TylerK07/HexCalc/images/HexCalc_PCB_Back.png

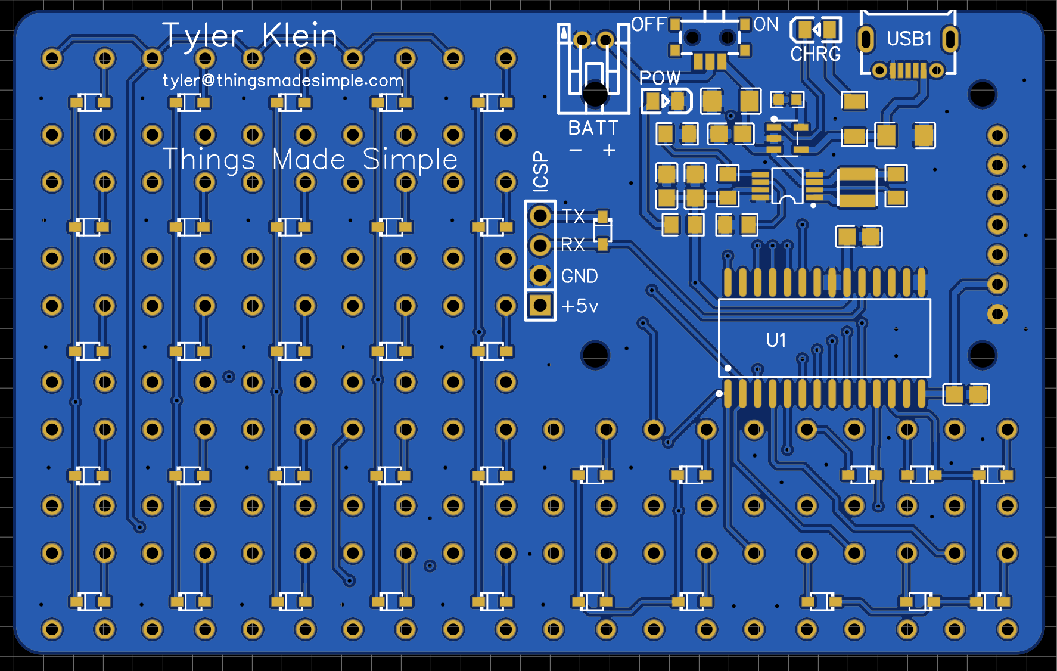
images/HexCalc_PCB_Back.png
