TylerK07/HexCalc/images/HexCalc_PCB_Front.png

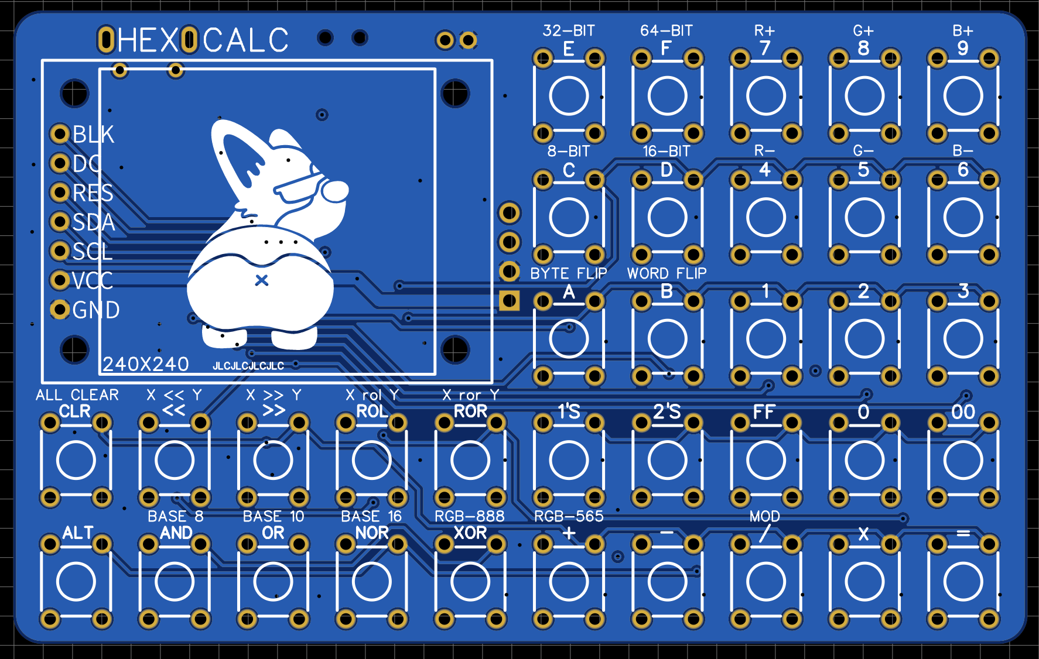
images/HexCalc_PCB_Front.png
