TylerK07/HexCalc/schematic/HexCalc_BOM_2024-06-30.csv

ID | Name | Designator | Footprint | Quantity | Manufacturer Part | Manufacturer | Supplier | Supplier Part | Price
1 | 4.7uF | C1,C2 | C1206 | 2 | 1206B475K500NT | FH(风华) | LCSC | C29823 | 0.032
2 | 22uF | C3,C4,C5 | C0805 | 3 | CL21A226MAQNNNE | SAMSUNG(三星) | LCSC | C45783 | 0.023
3 | 100nF | C6,C7 | C0805 | 2 | CL21B104KCFNNNE | SAMSUNG(三星) | LCSC | C28233 | 0.007
4 | 1N4148WS T4 | D1,D2,D3,D4,D5,D6,D7,D8,D9,D10,D11,D12,D13,D14,D15,D16,D17,D18,D19,D20,D21,D22,D23,D24,D25,D26,D27,D28,D29,D30,D31,D32,D33,D38,D39,D40 | SOD-323_L1.8-W1.3-LS2.5-RD | 36 | 1N4148WS | CJ(江苏长电/长晶) | LCSC | C2128 | 0.009
5 | Header-Male-2.54_1x4 | H1 | HDR-TH_4P-P2.54-V-M | 1 | B-2100S04P-A110 | Ckmtw(灿科盟) | LCSC | C124378 | 0.042
6 | 2.2uH | L1 | IND-SMD_L3.0-W3.0_SWPA3010S | 1 | SWPA3012S2R2MT | Sunlord(顺络) | LCSC | C36402 | 0.042
7 | 17-21SUYC/TR8 | LED1 | LED0805-R-RD | 1 | KT-0805黄灯 | KENTO | LCSC | C2296 | 0.012
8 | 0805G (Green) | LED2 | LED0805-R-RD | 1 | KT-0805G | KENTO | LCSC | C2297 | 0.014
9 | 2kΩ | R1 | R0603 | 1 | 0603WAF2001T5E | UNI-ROYAL(厚声) | LCSC | C22975 | 0.001
10 | 750kΩ | R2,R6 | R0805 | 2 | WR08X7503FTL | Walsin(华新科) | LCSC | C170959 | 0.003
11 | 1kΩ | R3 | R1206 | 1 | 1206W4F1001T5E | UNI-ROYAL(厚声) | LCSC | C4410 | 0.003
12 | 100kΩ | R4,R5 | R0805 | 2 | 0805W8F1003T5E | UNI-ROYAL(厚声) | LCSC | C149504 | 0.002
13 | 4.7kΩ | R7 | R0805 | 1 | 0805W8F4701T5E | UNI-ROYAL(厚声) | LCSC | C17673 | 0.002
14 | TA-3514-A1-B | SW1 | SW-SMD_TA-3514-A1-B | 1 | TA-3514-A1-B | Yuandi(元迪) | LCSC | C513999 | 0.16
15 | TACTILE_BUTTON_TE_1825910-6 | SW11,SW12,SW13,SW14,SW15,SW16,SW17,SW21,SW22,SW23,SW24,SW25,SW26,SW27,SW31,SW32,SW33,SW34,SW35,SW36,SW37,SW41,SW42,SW43,SW44,SW45,SW46,SW47,SW51,SW52,SW53,SW54,SW55,SW56,SW57 | TACTILE_BUTTON_TE_1825910-6_FOOTPRINT | 35
16 | AVR128DA28-I/SO | U1 | SOIC-28_L17.9-W7.5-P1.27-LS10.3-BL | 1 | AVR128DA28-I/SO | MICROCHIP(美国微芯) | LCSC | C1012827 | 4.552
17 | MCP73831T-2ACI/OT | U2 | SOT-23-5_L3.0-W1.7-P0.95-LS2.8-BL | 1 | MCP73831T-2ACI/OT | MICROCHIP(美国微芯) | LCSC | C424093 | 0.705
18 | S2B-PH-K-S-GW | U3 | CONN-TH_S2B-PH-K-S-GW | 1 | S2B-PH-K-S-GW | JST | LCSC | C157932 | 0.173
19 | PAM2401SCADJ | U4 | MSOP-8_L3.0-W3.0-P0.65-LS4.9-BL | 1 | PAM2401SCADJ | DIODES(美台) | LCSC | C508238 | 0.381
20 | 240X240 ST7789 TFT SPI DISPLAY | U6 | 240X240 1.3 TFT SPI DISPLAY | 1
21 | USB-Micro_1 | USB1 | MICRO-USB-SMD_5P-P0.65-H-F_C10418 | 1 |  | ValuePro | LCSC | C10418 | 0.058
