TylerK07/HexCalc/schematic/Schematic_HexCalc_2024-06-30.pdf

## Power Input & Battery Control

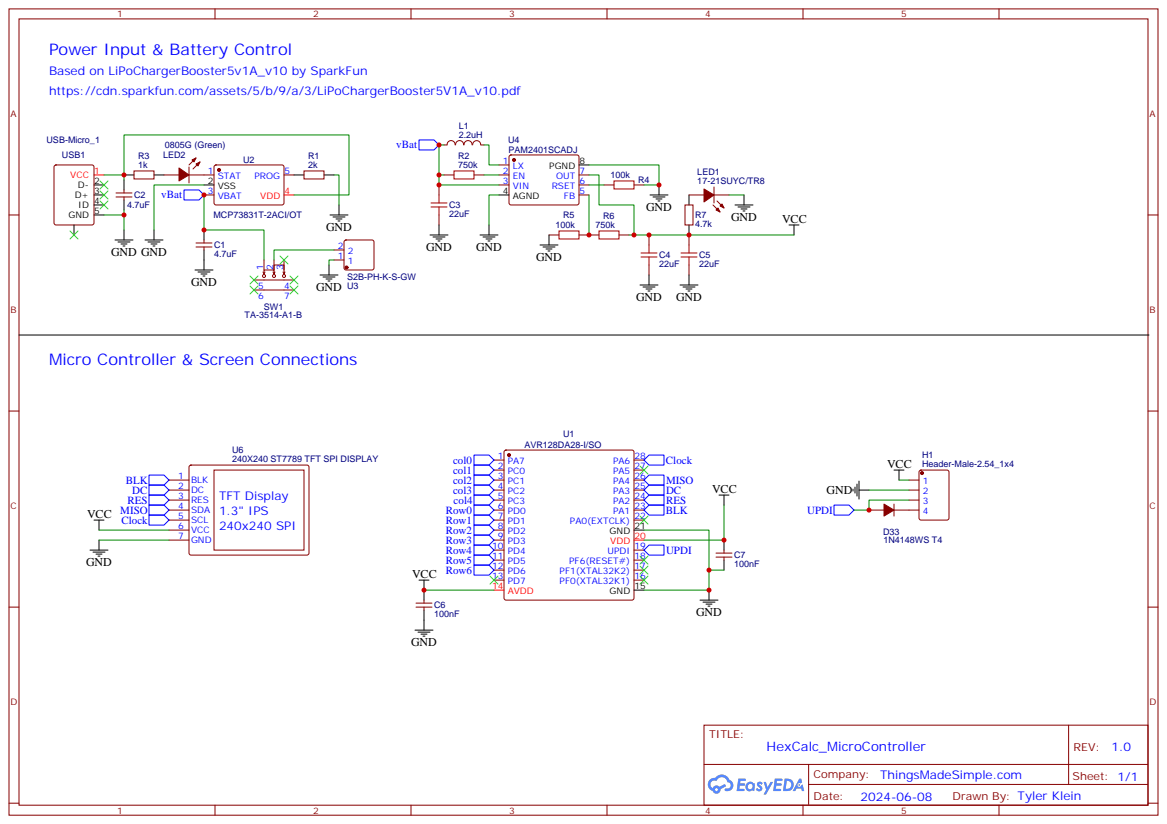
[picture p11: page 1]

Based on LiPoChargerBooster5v1A_v10 by SparkFun
https://cdn.sparkfun.com/assets/5/b/9/a/3/LiPoChargerBooster5V1A_v10.pdf

Micro Controller & Screen Connections

Drawn By: Tyler Klein

## Keyboard Matrix

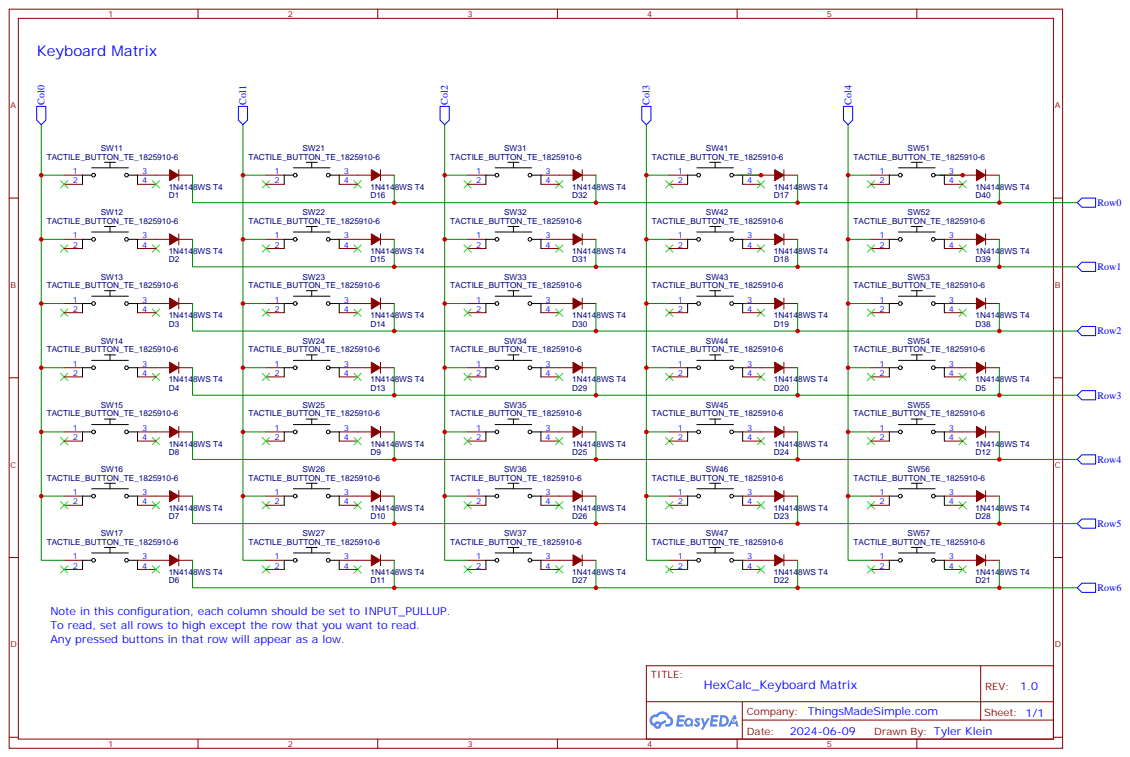
[picture p12: page 2]

Note in this configuration, each column should be set to INPUT_PULLUP.
To read, set all rows to high except the row that you want to read.
Any pressed buttons in that row will appear as a low.

Drawn By: Tyler Klein
