TylerK07/HexCalc/(commit log)

2024-07-01 Summary Updates
    Added some links to the summary
    [HexCalc_BOM_2024-06-30.csv]
2024-07-09 Overhauling the code
    Made some significant updates to the HexCalc.ino file to simplify things, add consistency in the function calls, and enough comments that I hopefully won't forget how everything works in a couple of years.
    [HexCalc.ino, calculator.h, hardware.h]
2024-07-11 Code cleanup and screen off timer
    A few updates:
    Cleaned up the calculator.h code
    Added a feature that turns off the screen backlight after 30 seconds (this can be adjusted in the .ino file)
    Fixed a bug in the right/left rotate function, so that should work now.
    Added a 24-bit version of word flip and byte flip that rotates bytes. This allows you to swap color channels in 24-bit color mode.
    [HexCalc.ino, calculator.h]
